nicotakuya/multiway-pad-converter/pad_conv_schematics.png

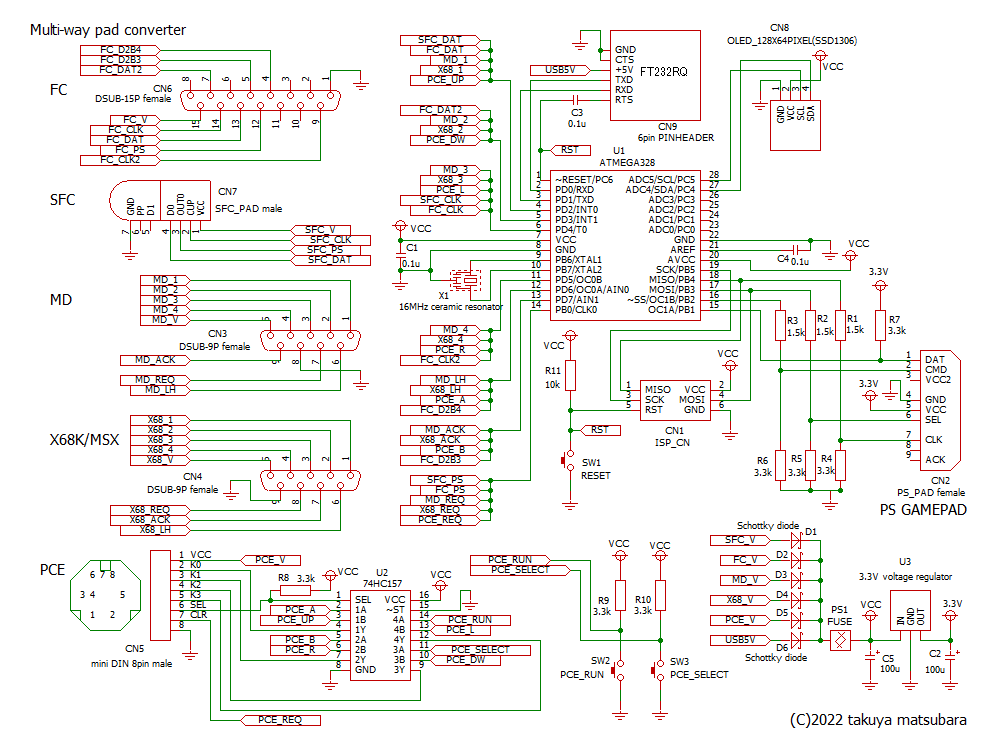
pad_conv_schematics.png
