nicotakuya/multiway-pad-converter/pad_conv_schematics_appendix.png

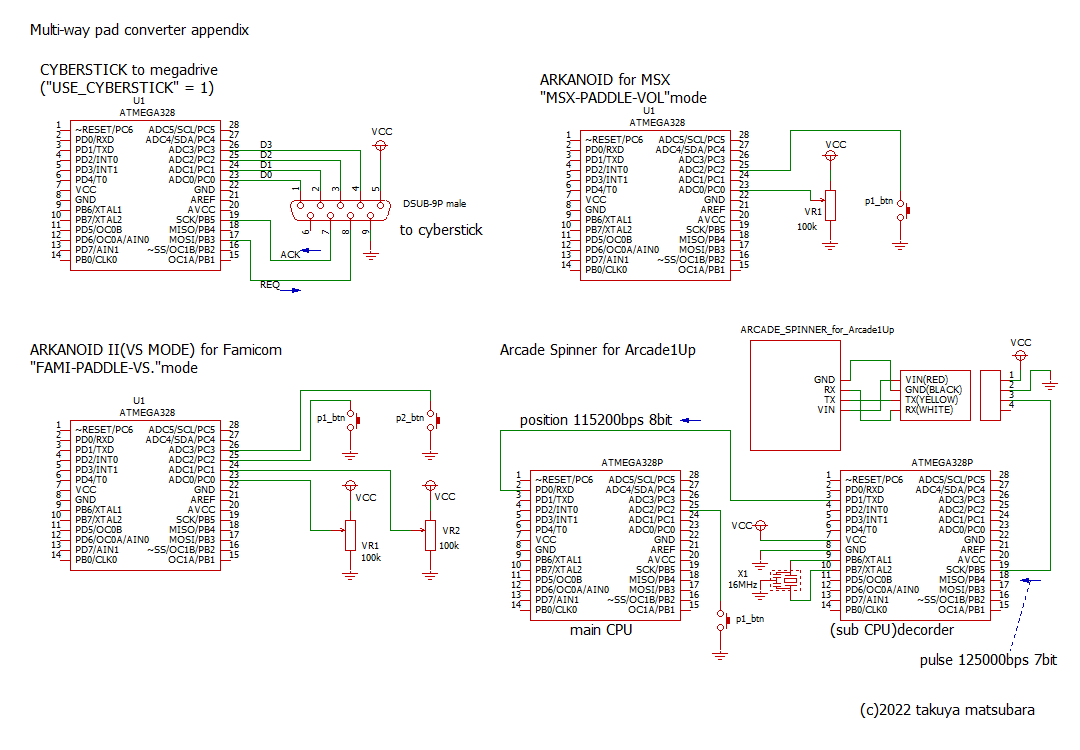
pad_conv_schematics_appendix.png
