nicotakuya/multiway-pad-converter/(commit log)

2022-06-23 bug fix(does not work vs. mode).
    [padconverter.ino]
2022-06-25 bug fix(OLED send error).
    [padconverter.ino]
2022-06-27 fix schematics.
2022-07-10 Bug fix(X68K_Analog and MD_Analog).
    [padconverter.ino]
2022-07-10 bug fix(X68K-Analog change speed supported).
    [padconverter.ino]
